RhomDev/projet_synth-se_broderie/docs/03_Capteurs_et_Synchronisation/Conditionnement_AOP_H21A1.md

---
titre: Module de Conditionnement du Signal Capteur (Comparateur LM393)
date: 2026-09-30
projet: Module Broderie
tags:
  - electronique
  - capteur
  - aop
  - comparateur
  - lm393
  - mks_base
  - kicad
  - pcb
statut: abandonne
aliases:
  - mise_en_service_capteur_h21a1
  - Conditionnement AOP H21A1
  - Module de correction du signal
  - Conditionnement LM393
---

# Module de Conditionnement du Signal Capteur (Comparateur LM393)

> [!WARNING] Module Obsolète / Remplacé (02/11/2026)
> Suite à l'abandon de la fourche optique H21A1, ce module de conditionnement analogique AOP/LM393 n'est plus requis dans l'architecture matérielle finale.
> Le microcontrôleur lit désormais directement un **[[Capteur_Fin_de_Course_Aiguille|fin de course mécanique standard]]** (contact sec 0V/5V) pour le homing et la position haute, et un **[[Encodeur_Rotatif_SEN0230|encodeur rotatif SEN0230]]**.
> Consulter la note explicative : `[[Note_Decision_Capteur_Fourche_H21A1|Note de Décision]]`.

## 1. Contexte et Problématique
La partie réceptrice du capteur optique à fente [[Fourche_Optique_H21A1|H21A1]]` se comporte comme une résistance variable. Selon la présence ou l'absence d'obstacle dans la fente, sa résistance interne passe de moins de $1\text{ M}\Omega$ à une valeur comprise entre $3\text{ M}\Omega$ et $6\text{ M}\Omega$.

<<<<<<< HEAD
* **À vide (mesure au multimètre) :** La tension varie parfaitement entre $5\text{ V}$ et environ $0{,}8\text{ V}$. Cette plage est théoriquement idéale pour le microcontrôleur de la carte `[[Carte_MKS_Base_V1_4|MKS Base V1.4]]`, car toute tension inférieure à $1{,}5\text{ V}$ est considérée comme un niveau logique bas (`LOW`) stable, permettant la détection fiable d'un front descendant (`FALLING`).
* **En charge (connecté à la carte hôte) :** Lorsque la sortie du capteur est reliée à l'entrée numérique du microcontrôleur, la tension basse remonte à cause des résistances internes de tirage de la carte. La tension stagne alors autour de $2{,}0\text{ V} - 2{,}5\text{ V}$, ce qui représente une zone d'incertitude instable pour l'étage d'entrée logique du processeur ATmega2560 ($1{,}5\text{ V} < V < 3{,}0\text{ V}$).
=======
* **À vide (mesure au multimètre) :** La tension varie parfaitement entre $5\text{ V}$ et environ $0{,}8\text{ V}$. Cette plage est théoriquement idéale pour le microcontrôleur de la carte [[Carte_MKS_Base_V1_4|MKS Base V1.4]]`, car toute tension inférieure à $1{,}5\text{ V}$ est considérée comme un niveau logique bas (`LOW`) stable, permettant la détection fiable d'un front descendant (`FALLING`).
* **En charge (connecté à la carte hôte) :** Lorsque la sortie du capteur est reliée à l'entrée numérique du microcontrôleur, la tension basse remonte à cause des résistances internes de tirage de la carte. La tension stagne alors autour de $2{,}0\text{ V} - 2{,}5\text{ V}$, ce qui représente une zone d'incertitude instable pour l'étage d'entrée logique du processeur ATmega2560.
>>>>>>> ce25f4e (Fix: résolution conflit workspace.json)

---

## 2. Choix Technologique : Du LM741/TL081 au Comparateur Dédié LM393
Pour isoler le capteur de l'influence de la carte et garantir une détection sans faille, nous avons conçu un module intermédiaire de conditionnement.

> [!IMPORTANT]
> Les tests expérimentaux avec des amplificateurs opérationnels classiques (LM741, TL081CN, LM318N) ont révélé qu'ils **ne conviennent pas** en alimentation unilatérale $0\text{ V} / 5\text{ V}$ car ils ne sont pas *rail-to-rail* (perte de $1{,}5\text{ V}$ à $2\text{ V}$ aux bornes).
> Le composant validé est le **LM393**, un vrai comparateur de tension à alimentation simple ($5\text{ V}$) avec sortie à collecteur ouvert (voir l'étude complète dans `[[comparateur-aop-choix]]` et la `[[Note_Decision_Capteur_Fourche_H21A1]]`).

Son rôle est de convertir la tension analogique instable issue du capteur en un signal tout-ou-rien digital parfaitement franc ($0\text{ V}$ ou $5\text{ V}$ purs) :

$$V_{out} = \begin{cases} 5\text{ V} & \text{si } V^+ > V^- \\ 0\text{ V} & \text{si } V^+ < V^- \end{cases}$$

```
                +5V
                 |
             [R_pullup]
                 |
      Capteur----+-----> (V+) Non-Inverseuse
      H21A1                |
                          |\
                          | \
                          |  \-----> Sortie Digitale D (vers MKS Pin 19)
                          |  /
    Potentiomètre -----> (V-) /
    (Seuil V_ref)         |/
```

---

## 3. Analyse du Montage Électrique
Le montage s'articule autour de trois blocs fonctionnels reliés à l'AOP (modélisé par un composant type LM741 / LM358) :

1. **Signal Capteur (Entrée Non-Inverseuse $V^+$) :** Le phototransistor forme un pont diviseur avec sa résistance de charge reliée au $5\text{ V}$. La tension à ce point est injectée sur la broche $V^+$.
2. **Seuil de Référence Ajustable (Entrée Inverseuse $V^-$) :** Un potentiomètre monté en pont diviseur entre $5\text{ V}$ et la masse permet d'ajuster manuellement la tension de seuil de référence $V_{\text{ref}}$ (fixée typiquement vers $1{,}5\text{ V} - 1{,}8\text{ V}$).
3. **Sortie Digitale Saturation :** L'AOP compare instantanément $V^+$ et $V^-$. Dès que le drapeau mécanique obture le faisceau, la tension chute sous $V_{\text{ref}}$, et la sortie bascule immédiatement à $0\text{ V}$ franc.

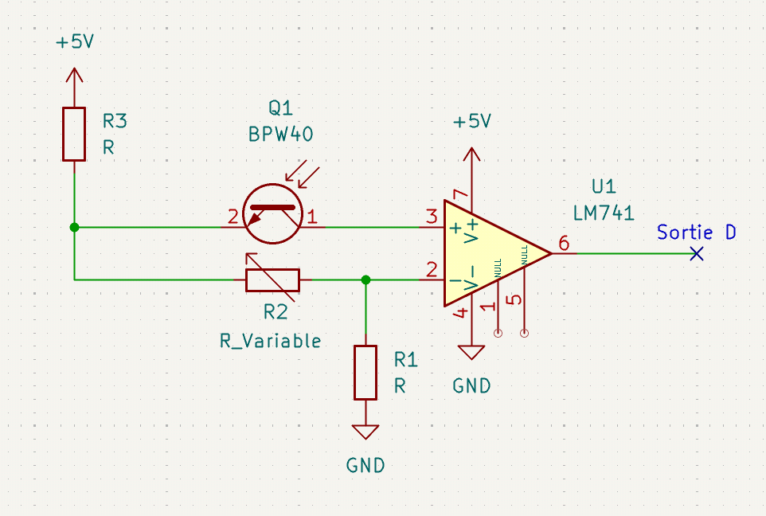
[picture p1: docs/assets/montage_correction.png]
Schéma de correction


---

## 4. Réalisation Matérielle (KiCad PCB)
Le circuit complet a été saisi et routé sous KiCad dans le dossier [`hardware/elect/carte_acquisition_capteur/`](file:///home/rhomdev/Documents/Ecole/projet_synth-se_broderie/hardware/elect/carte_acquisition_capteur/) :
* Schéma électronique : `carte_acquisition_capteur.kicad_sch`
* Circuit imprimé : `carte_acquisition_capteur.kicad_pcb`
* Trous de fixation : 3 trous mécaniques prévus pour fixation rigide sur le châssis.

---

## 5. Procédure de Calibration & Validation
1. Mettre le circuit sous tension $5\text{ V}$.
2. Relever au multimètre la tension haute ($V_{\text{haut}} \approx 4{,}8\text{ V}$) et basse ($V_{\text{bas}} \approx 2{,}2\text{ V}$) délivrées par le capteur sous charge.
3. Régler le potentiomètre pour que $V^-$ se situe exactement à la valeur médiane :
   $$V_{\text{ref}} = \frac{V_{\text{haut}} + V_{\text{bas}}}{2} \approx \frac{4{,}8 + 2{,}2}{2} = 3{,}5\text{ V}$$
4. Vérifier que la sortie bascule de façon nette entre $0\text{ V}$ et $5\text{ V}$ lors de la rotation de l'arbre.
5. Valider la réception d'interruption avec le sketch Arduino : `src/arduino/test_H21A1/test_H21A1.ino`.

---
**Voir aussi :**
<<<<<<< HEAD
* `[[Note_Decision_Capteur_Fourche_H21A1|Note de Décision : Maintien du H21A1 vs Encodeur]]`
* `[[comparateur-aop-choix|Note de Conception : Choix de l'AOP / Comparateur LM393]]`
* `[[Fourche_Optique_H21A1|Fiche Capteur H21A1]]`
* `[[Carte_MKS_Base_V1_4|Connexion à la Carte MKS Base]]`
* `[[00_Tableau_de_Bord|Tableau de Bord]]`
* Code de test : `src/arduino/test_H21A1/test_H21A1.ino`
=======
* [[Fourche_Optique_H21A1|Fiche Capteur H21A1]]`
* [[Carte_MKS_Base_V1_4|Connexion à la Carte MKS Base]]`
* [[00_Tableau_de_Bord|Tableau de Bord]]`
>>>>>>> ce25f4e (Fix: résolution conflit workspace.json)
