RhomDev/projet_synth-se_broderie/reports/presentation/Jalon_1.pptx

## Le projet et ses missions

CAHIER DES CHARGES

Objectif
Broder automatiquement un motif vectoriel avec une machine à coudre mécanique Janome Facility 21.

Point de départ
Un plateau XY à deux moteurs pas-à-pas et une carte MKS Base V1.4 (ATmega2560) sont déjà installés.

Mécanique
- Éviter les collisions avec la partie mobile du plateau
- Ajout d'un encodeur pour récupérer en temps réel la position verticale de l'aiguille

Icône Mécanique

Synchronisation
Ne déplacer le cadre que lorsque l'aiguille est sortie du tissu.

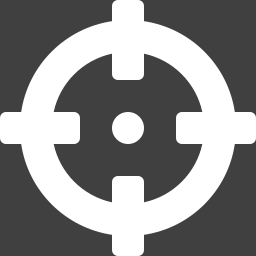
[picture p4: figure]
Icône Synchronisation

1 · Image

Moteur principal
Régler la vitesse du moteur 230 V avec un variateur à découpe de phase.

Icône Moteur principal

2 · Python : G-code

3 · MKS Base : firmware

Logiciel
Convertir un motif en G-code et l'envoyer à la carte par liaison série.

Icône Logiciel

4 · Machine : aiguille + plateau XY

Notes: Objectif : une machine à coudre mécanique qui brode toute seule un motif vectoriel. Le plateau XY et la carte MKS Base sont déjà installés. Quatre missions : mécanique, synchronisation avec l'aiguille, moteur principal, logiciel.

## Exigences et évolutions

CAHIER DES CHARGES

103,5 × 103,5 mm

Aire utile de broderie

DÉTECTION DE L'AIGUILLE
Prévu : Fourche optique H21A1 avec comparateur
Actuel : Fin de course mécanique + encodeur SEN0230
Pourquoi : électronique complexe, difficultés à détecter l'obstacle (peu d'influence sur la tension en sortie du capteur).

≈ 860 tr/min

Vitesse maximale de la machine

15 à 30 ms

Fenêtre pour déplacer le cadre à chaque tour

Avant le 18/12

Première broderie complète

À définir

Vitesse de couture et précision

VARIATEUR DU MOTEUR
Prévu : Module variateur RobotDyn
Actuel : RobotDyn pour tester ; variateur fait maison en bonus
Pourquoi : un variateur sûr pour tester, et de l'expérience en conception.

Règle absolue : le cadre ne bouge jamais tant que l'aiguille est dans le tissu.

Notes: À gauche, les exigences fixées dans le cahier des charges (la vitesse de couture et la précision ne sont pas encore définies). À droite, les deux évolutions depuis la première version : le capteur d'aiguille (décision du 2 novembre) et le variateur.

## Planning : ce qui est fait

PLANNING · CE QUI EST FAIT

28/09

05/10

12/10

19/10

26/10

02/11

Phase 1 : Cadrage & Spécifications

Prise en main du sujet & définition du besoin

Analyse de la machine Janome Facility 21

Rédaction du Cahier des Charges fonctionnel

Déploiement coffre Obsidian & arborescence Git

Phase 2 : Études Préliminaires & Choix Techniques

Analyse de la carte MKS Base V1.4 (ATmega2560)

Étude du variateur AC RobotDyn (découpe de phase)

Étude théorique Fast PWM vs découpe AC

Étude initiale de la fourche optique H21A1

Conception PCB comparateur AOP pour H21A1

Essais comparateurs (LM318, TL081, LM393)

Phase 3 : Expérimentation, Tests Manuels & Pivot

Dimensionnement cinématique poulie encodeur

Test manuel couture machine (carré piqué réussi)

Décision : Abandon H21A1 au profit du Fin de Course

Choix du fin de course à galet (PMH & homing)

Validation encodeur rotatif SEN0230 (< 5000 tr/min)

Établissement de la liste des besoins (BOM)

Notes: Les trois premières phases du Gantt sont terminées : cadrage, études préliminaires, puis tests manuels et pivot sur les capteurs.

## Planning : ce qu'il reste à faire

PLANNING · CE QU'IL RESTE À FAIRE

02/11

16/11

30/11

14/12

28/12

11/01

25/01

4 · Conception mécanique & achats 04/11 → 19/11
Commande, plateau XY, poulie, support encodeur, came

5 · Électronique & câblage 11/11 → 20/11
Boîtier 230 V, câblage moteurs, capteurs, encodeur

6 · Firmware Arduino 16/11 → 04/12
Variateur, encodeur, homing, synchro aiguille/XY, G-code

7 · Logiciel Python 20/11 → 11/12
Liaison série, extraction SVG, G-code, visualiseur 2D

8 · Intégration & essais 04/12 → 18/12
Essais à vide, premier carré, optimisation, motif complet

Vacances de Noël 19/12 → 01/01

9 · Rapport & soutenance 04/01 → 28/01
Rapport, diaporama et vidéo, répétitions, soutenance

Aujourd'hui (03/11)

◆ Soutenance 28/01

Notes: Les six phases restantes, de novembre à la soutenance du 28 janvier. Les tâches détaillées de chaque phase sont dans le Gantt du dépôt.

## Matériel à acheter

MATÉRIEL

Désignation | Qté | Prix | Rôle
Encodeur rotatif SEN0230 | 1 | 29,90 € | Suivi de vitesse et d'angle
Variateur AC RobotDyn | 1 | 29,04 € | Variateur de référence (230 V) (Bonus -> variateur maison)
Fins de course du plateau X/Y | 4 | 11,20 € | Homing et butées de sécurité
Fin de course de l'aiguille | 1 | 2,80 € | Point mort haut et homing (type à confirmer)
Variateur fait maison : H11AA1, MOC3021M, BTA16-600C | 3 | 4,04 € | Variateur fait maison (Bonus -> Variateur AC RobotDyn)
Total | | 76,98 € | dont 4,04 € ou 29,04 € de bonus

Poulie crantée de l'encodeur : impression 3D, sans achat.

Notes: Budget total d'environ 77 euros. Un des deux variateurs est un bonus : les trois composants du variateur fait maison (4,04 euros) si on utilise le RobotDyn, ou le RobotDyn (29,04 euros) si on utilise le variateur fait maison. La poulie de l'encodeur est imprimée en 3D.
