RhomDev/projet_synth-se_broderie/docs/01_Gestion_Projet/Tutoriel_Machine_a_Coudre.md

---
titre: Tutoriel Prise en Main & Enfilage — Machine à Coudre Janome Facility 21
date: 2026-11-02
projet: Module Broderie
tags:
  - machine
  - couture
  - tutoriel
  - video
statut: valide
aliases:
  - Tuto Machine a Coudre
  - Video Janome
---

# 🧵 Tutoriel Vidéo : Fonctionnement & Enfilage de la Janome Facility 21

Ce tutoriel vidéo a servi de support d'apprentissage pour la prise en main de la machine, le bobinage de la canette, le passage du fil supérieur et le réglage des tensions lors de la séance du 02 novembre 2026 :

* **Lien vidéo YouTube :** [Tutoriel Machine à Coudre Janome Facility 21](https://www.youtube.com/watch?v=w-LbGgq0WxE)

---
**Voir aussi :**
*  [[2026-11-02|Journal du 02 Novembre 2026 (Essais réussis)]] 
*  [[fiche technique - janome facility 21.pdf|Fiche Technique Janome Facility 21]]
