RhomDev/projet_synth-se_broderie/docs/templates/Template_Fiche_Technique.md

---
titre: 
date: {{date}}
projet: Module Broderie
tags:
  - fiche_technique
  - electronique
  - materiel
statut: en cours
aliases:
  - 
---

# {{title}}

## 1. Présentation & Rôle dans le Projet
<!-- Décrire ici la fonction du composant/module et pourquoi il est utilisé dans la brodeuse -->

## 2. Caractéristiques Techniques Principales
<!-- Tableau ou liste à puces des spécifications clés (tension, courant, fréquence, etc.) -->

| Paramètre | Valeur | Remarques |
| :--- | :--- | :--- |
| **Tension d'alimentation** | | |
| **Interface de commande** | | |
| **Composant clé** | | |

## 3. Schéma de Câblage & Intégration
<!-- Schéma de raccordement avec la carte MKS Base ou les capteurs -->

## 4. Code / Firmware Associé
<!-- Extrait de code de test ou de configuration des registres -->

```cpp
// Code d'exemple / configuration
```

## 5. Tests, Mesures & Validation
<!-- Relevés expérimentaux, captures de signaux, points de vigilance -->

---
**Références & Documents associés :**
* `[[00_Tableau_de_Bord|Tableau de Bord]]`
*
