RhomDev/projet_synth-se_broderie/docs/templates/Template_Tache.md

---
titre: 
date: {{date}}
projet: Module Broderie
tags:
  - tache
  - gestion_projet
statut: a_faire
priorite: moyenne
responsable: 
---

# 📌 {{title}}

## 1. Description du Besoin / Objectif
<!-- Pourquoi cette tâche est nécessaire et quel est le résultat attendu -->

## 2. Critères d'Acceptation & Validation
- [ ] 
- [ ] 

## 3. Notes Techniques & Démarche
<!-- Schémas, liens vers la documentation, démarches de test -->

## 4. Résultats & Clôture
<!-- Relevés, photos ou liens vers les commits réalisant la tâche -->

---
**Voir aussi :**
* `[[Suivi_des_Taches|Feuille de Route Générale]]`
* `[[00_Tableau_de_Bord|Tableau de Bord]]`
