RhomDev/projet_synth-se_broderie/docs/assets/IMG_20260925_122632_784.jpg

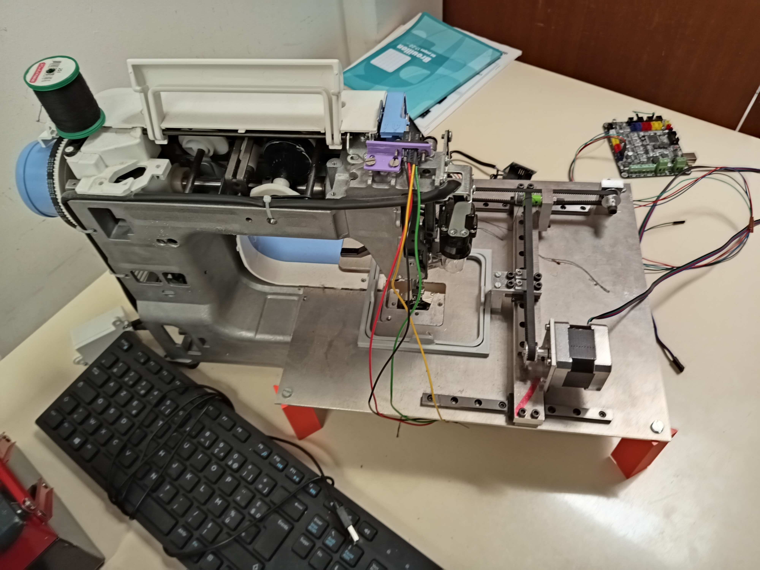
docs/assets/IMG_20260925_122632_784.jpg
