RhomDev/projet_synth-se_broderie/docs/assets/IMG_20260925_122636_920.jpg

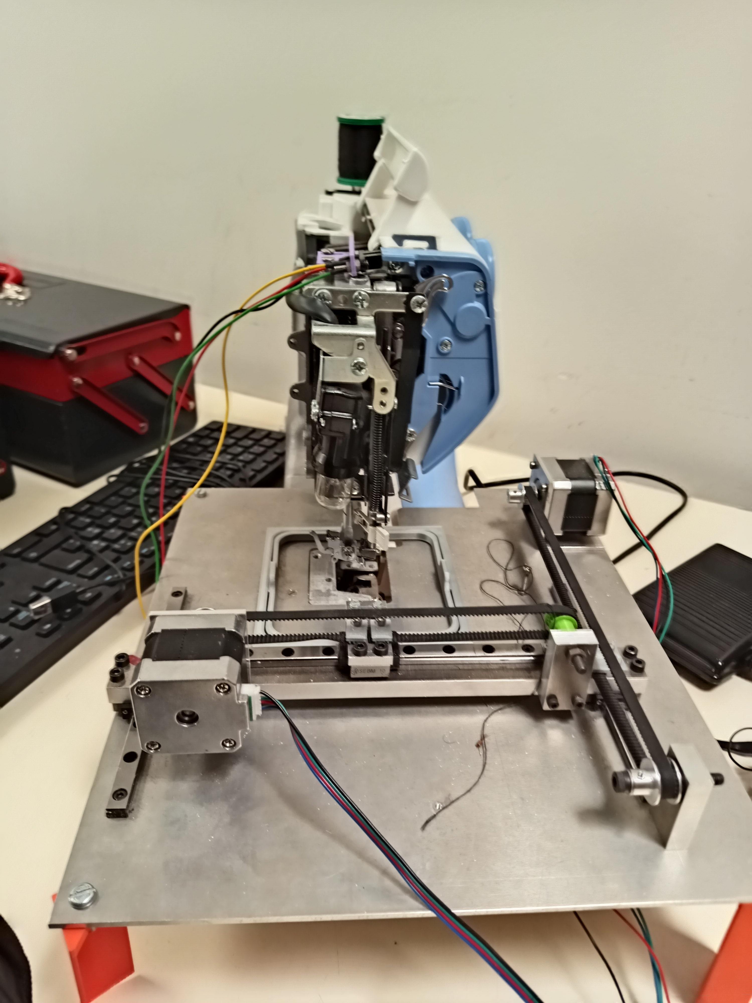
docs/assets/IMG_20260925_122636_920.jpg
