RhomDev/projet_synth-se_broderie/docs/assets/IMG_20260925_122641_185.jpg

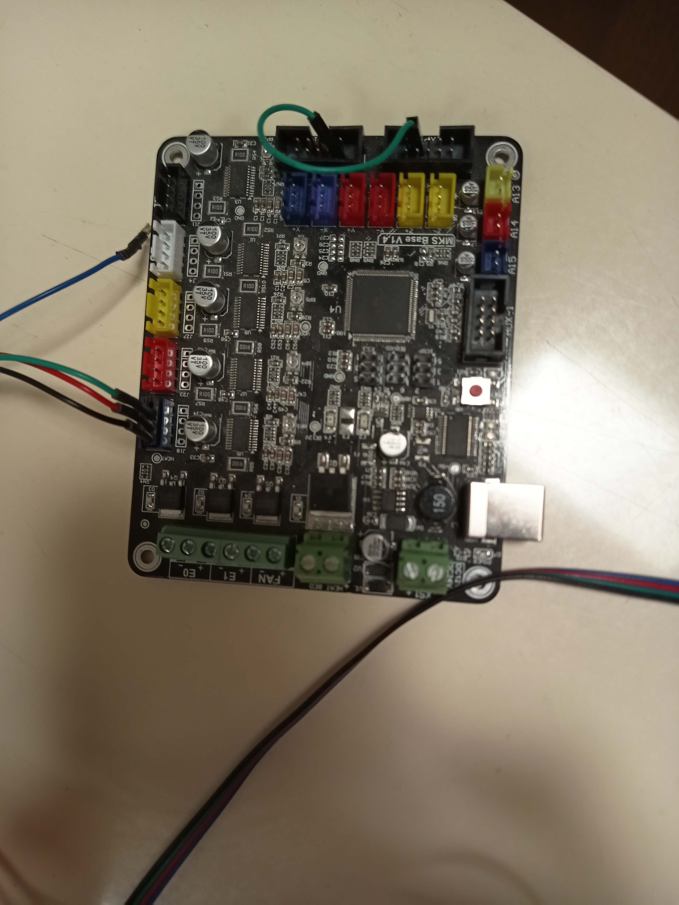
docs/assets/IMG_20260925_122641_185.jpg
