RhomDev/projet_synth-se_broderie/docs/assets/IMG_20260925_122648_890.jpg

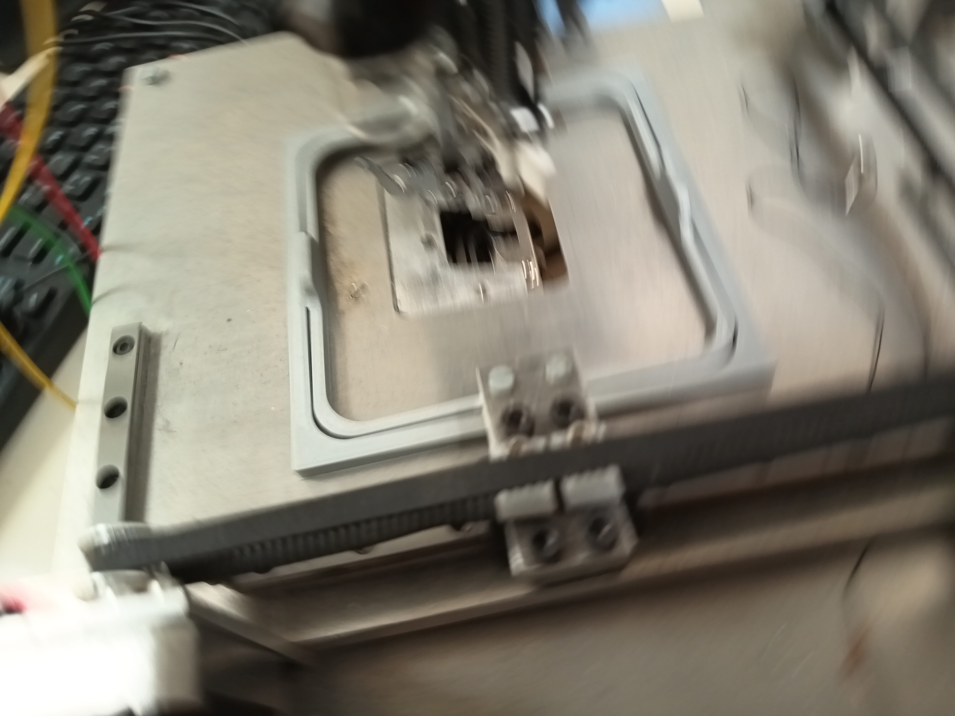
docs/assets/IMG_20260925_122648_890.jpg
