RhomDev/projet_synth-se_broderie/docs/assets/IMG_20260925_122655_627.jpg

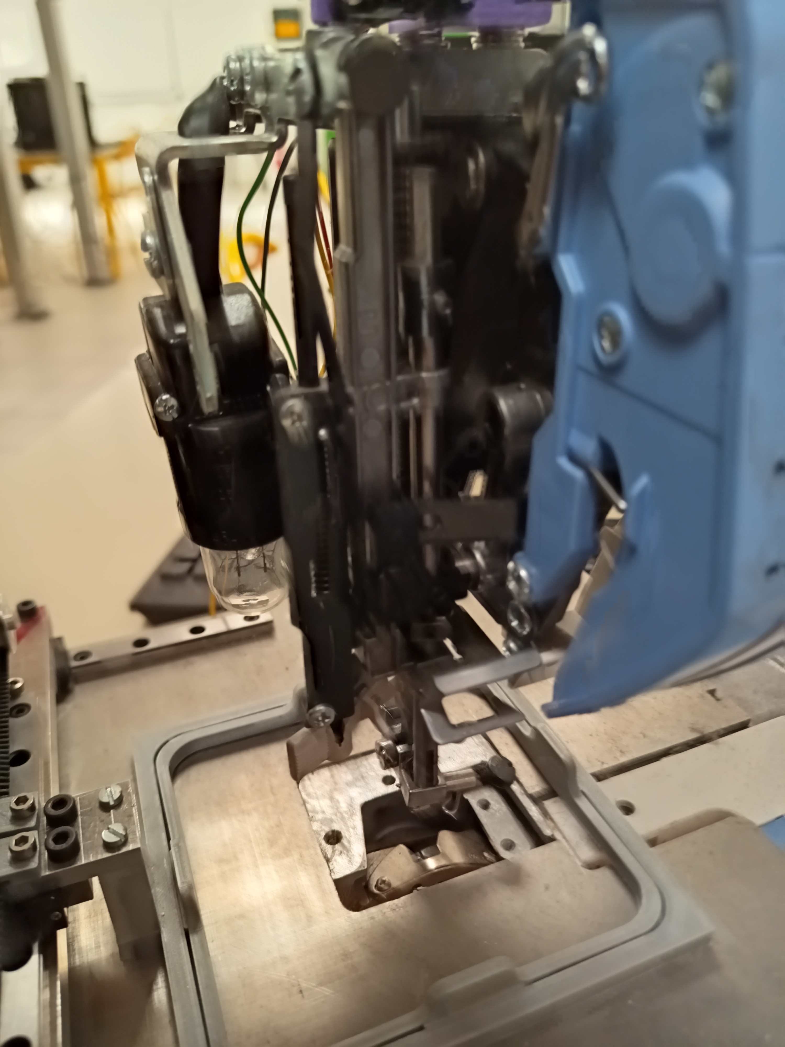
docs/assets/IMG_20260925_122655_627.jpg
