RhomDev/projet_synth-se_broderie/docs/assets/IMG_20260925_122702_841.jpg

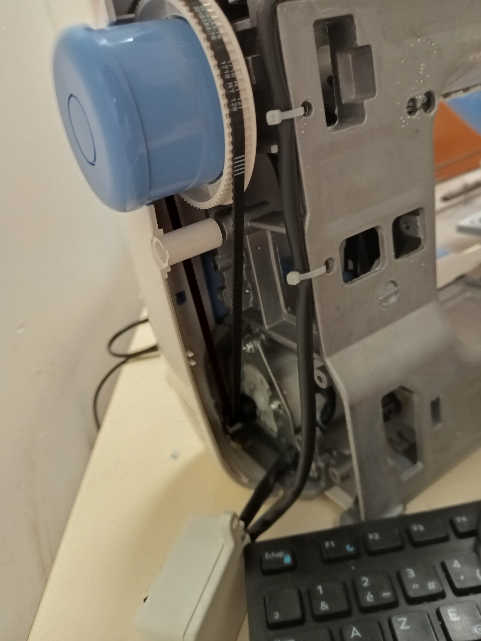
docs/assets/IMG_20260925_122702_841.jpg
