RhomDev/projet_synth-se_broderie/hardware/elect/Variation_AC.png

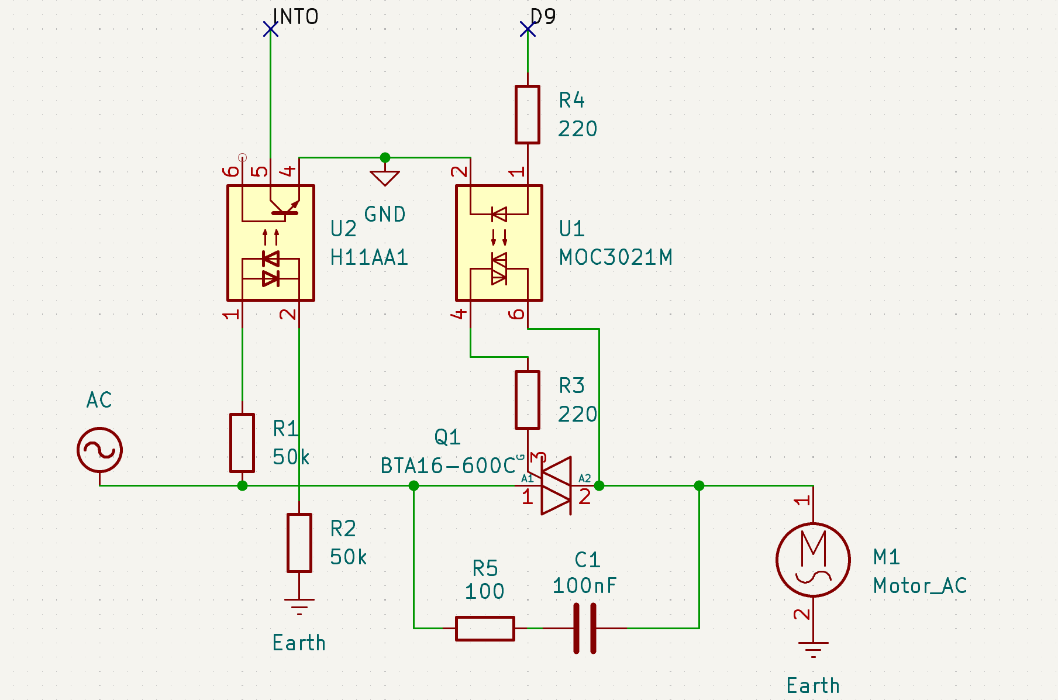
hardware/elect/Variation_AC.png
