RhomDev/projet_synth-se_broderie/docs/02_Electronique_et_Puissance/Produits_a_acheter.xlsx

 |  | reference | quantity | prix | total | liens
 |  |  |  |  | 0
 |  |  |  |  | 0
hacheur RobotDyn | hacheur complet | sku EB0046830 | 1 | 29.04 | 29.04 | Module variateur de lumière AC pour contrôleur PWM, 1 canal 3.3V/5V logique AC 50hz 60hz 220V 110V pour Arduino (https://www.elecbee.com/fr/product-detail/ac-light-dimmer-module-for-pwm-controller-1-channel-3-3v-5v-logic-ac-50hz-60hz-220v-110v-for-arduino_28960)
Détection du passage à zéro du secteur |  | H11AA1 (U2) | 1 | 1.4 | 1.4 | https://www.gotronic.fr/art-optocoupleur-h11aa1-31848.htm
opto-triac | Opto-triac sans détection de zéro | MOC3021M (U1) | 1 | 1.04 | 1.04 | Optotriac MOC3021 | Gotronic (https://www.gotronic.fr/art-optotriac-moc3021-2360.htm)
Triac |  | BTA16-600C (Q1) | 1 | 1.6 | 1.6 | https://www.gotronic.fr/art-triac-bta16-600c-22671.htm
 |  |  |  |  | 0
Récepteur IR |  | TSOP2238 | 1 | 0.89 | 0.89 | TSOP2238 | Récepteur IR Vishay, 38 kHz ±45° 5.5V 45 m 2.5 V Traversant TSOP 6.95 mm 3 broches 6 mm 5.6mm | RS (https://fr.rs-online.com/web/p/recepteurs-ir/7085562?gb=a)
Led IR |  | SIR-56ST3F | 1 | 0.51 | 0.51 | SIR-56ST3F | Diode infrarouge, ROHM 2 broches, Traversant, 8 mW/sr, 950 nm DIP | RS (https://fr.rs-online.com/web/p/leds-infrarouges/1780575?gb=a)
 |  |  |  |  | 0
 |  |  |  |  | 0
butee fin de course | pour les deplacement du plateau |  | 4 | 2.8 | 11.2
 |  |  |  | total | 45.68
