RhomDev/projet_synth-se_broderie/(list of files, cad)

Other CAD files:
hardware/meca/support2_led_capteur.prt
hardware/meca/support_led_capteur_V2.prt
hardware/meca/tige.prt
hardware/meca/tuillère_broderie.prt
hardware/meca/tuillère_broderie_axe_x.prt
