RhomDev/projet_synth-se_broderie/reports/journal/2026-11-05.md

---
titre: Journal de bord - 2026-11-05
date: 2026-11-05
tags:
  - journal
  - projet_broderie
  - decision
  - capteurs
  - impression_3d
  - mecanique
  - electronique
  - firmware
statut: valide
aliases:
  - Journal du 05 Novembre 2026
---

# Journal de bord — 05 novembre 2026

## 👥 Intervenants
* **RhomDev** (Romaric Pradeau)
* **matazzo** (Maé Tazzioli)

---

## 1. Travaux Réalisés

### Pôle Réflexion & Décisions (après la soutenance intermédiaire)
* **Abandon de l'encodeur SEN0230.** Après réflexion et sur les conseils reçus après la soutenance intermédiaire, l'encodeur n'est plus retenu. Cette décision remplace l'architecture hybride validée le 2 novembre (fin de course + encodeur).
* **Étude de la plage de temps pour déplacer le tissu.** Le cadre ne peut bouger que lorsque l'aiguille est sortie du tissu et que la tension du fil est bonne. Cette plage est la fenêtre d'avance (détail dans la section « Étude du moment exact du déplacement du tissu »).
* **Principe retenu : deux capteurs optiques sur la course de l'aiguille.**
  * Une tige fixée au bout de l'aiguille monte et descend avec elle, et passe dans la fourche de chaque capteur : elle coupe le faisceau entre l'émetteur et le récepteur.
  * Le **capteur bas** détecte l'aiguille au niveau où le mouvement du tissu doit commencer. Le mouvement démarre quand l'aiguille, en remontant, déclenche ce capteur.
  * Le **capteur haut** détecte l'aiguille tout en haut. Le mouvement doit être terminé quand l'aiguille y arrive.

### Étude du moment exact du déplacement du tissu
Les valeurs d'angle ci-dessous sont des ordres de grandeur : elles dépendent du modèle de machine et doivent être mesurées sur la Facility 21.

**Sur une machine à coudre classique**, le tissu avance quand l'aiguille est sortie du tissu, pendant la remontée. Un cycle de point se déroule ainsi :
1. **Aiguille en bas** (pointe sous la plaque à aiguille) : le pied-de-biche maintient le tissu, les griffes sont abaissées sous la plaque. Le crochet attrape la boucle du fil supérieur.
2. **Aiguille qui remonte** : dès que la pointe est sortie du tissu, les griffes d'entraînement se soulèvent à travers la plaque, serrent le tissu contre le pied-de-biche et le tirent vers l'arrière, d'une longueur égale à celle du point.
3. **Aiguille en haut** : les griffes redescendent sous la plaque, le tissu est libre.
4. **Aiguille qui redescend** : le tissu doit être immobile avant que la pointe ne le perce de nouveau.

Si le tissu bouge aiguille engagée, l'aiguille se tord ou casse et le point est faussé. Mécaniquement, le calage entre l'arbre principal (aiguille et crochet) et l'arbre d'entraînement, par came excentrique ou bielle, garantit ce déphasage. Les griffes décrivent une trajectoire quasi elliptique (montée, avance, descente, retour). L'avance s'effectue pendant environ **120 à 180° de rotation de l'arbre principal**, centrés autour de la phase où l'aiguille est haute.

**Condition nécessaire mais pas suffisante : la tension du fil.** « Aiguille sortie du tissu » ne suffit pas : si le fil est encore engagé dans le tissu et que le crochet tient la boucle, avancer trop tôt tire le fil de travers, déforme le point ou casse le fil. Séquence indicative sur un point (0° = aiguille en haut) :

| Phase | Angle indicatif | Ce qui se passe |
| :--- | :--- | :--- |
| Descente | ~0° à ~100° | L'aiguille perce le tissu vers 70 à 90° : le tissu doit être immobile avant. |
| Aiguille en bas, boucle | ~180° à ~200° | Le fil forme une boucle quand l'aiguille remonte légèrement, et le crochet l'attrape. |
| Remontée | ~200° à ~300° | Le crochet emporte la boucle autour de la canette. L'aiguille sort du tissu vers 270 à 300°. |
| Serrage du point | ~300° à ~360° | Le tire-fil (levier de tension) monte et resserre le point. |

**Fenêtre utile :** de la fin du serrage du point (tire-fil à peu près en haut) jusqu'à l'entrée de la pointe dans le tissu à la descente, soit à peu près **300° → 360° → 60°**. C'est cohérent avec les machines classiques (entraînement sur environ 120° centrés sur l'aiguille haute).

**Pour mesurer la plage exacte sur la Facility 21 :**
1. Tourner le volant à la main, avec un tissu fin et un fil visible.
2. Relever l'angle de la sortie de la pointe du tissu, du début et de la fin de la montée des griffes, de la position haute du tire-fil, et de l'entrée de la pointe à la descente.
3. Avancer le tissu sur des fenêtres de plus en plus larges et observer à partir de quand le fil tire ou que le point se dégrade. Garder une marge de sécurité de 10 à 15° de chaque côté.

**Pour la broderie**, il n'y a pas de griffes : l'axe XY joue ce rôle. La fenêtre se règle donc dans le code et peut être plus stricte que celle d'une machine classique, pour protéger le fil. La règle des deux capteurs (mouvement lancé quand l'aiguille remontante déclenche le capteur bas, terminé quand elle arrive en haut) s'inscrit dans cette fenêtre, et s'arrête avant l'entrée de la pointe dans le tissu.

### Pôle Capteurs
* **Alternatives à la fourche H21A1 étudiées :** modules à fourche optique avec comparateur LM393 (FC-03, HW-206), qui donnent une vraie sortie tout ou rien directement exploitable par un Arduino, et capteurs à effet Hall (A3144, KY-003) avec un aimant, insensibles à la poussière et aux peluches. Le H21A1 seul n'a pas de trigger de Schmitt : ses fronts sont mous et peuvent causer des rebonds ou de faux comptages.
* **Capteur optique plus performant trouvé :** fourche optique **Vishay TCST2300** (fente de 0,25 mm, résolution spatiale de 0,2 mm). La fiche `[[Capteur_Optique_TCST2300]]` et sa datasheet sont ajoutées au dépôt, et les datasheets de la LED IR et du récepteur TSOP22 sont rangées dans `docs/datasheets/detection_aiguille/`.
* **Capteur de fin de course pour le plateau trouvé** (axes X et Y).

### Pôle Fabrication (impression 3D)
* **Support des capteurs de l'aiguille.**
* **Tige** placée au bout de l'aiguille : elle passe dans la fourche des capteurs optiques et bloque la lumière entre l'émetteur et le récepteur quand l'aiguille monte ou descend.
* **Supports des fins de course du plateau :** ils maintiennent les capteurs et se clipsent ou glissent dans les rails X et Y où coulisse le support qui porte le plateau.
* Les fichiers CAO correspondants (`hardware/meca/support_led_capteur_V2.prt`, `support2_led_capteur.prt`, `tige.prt`) sont ajoutés au dépôt le 9 novembre.

### Pôle Électronique
* **Soudage des fils** sur les capteurs de fin de course.

### Pôle Firmware
* **Initialisation des registres** pour contrôler les moteurs pas à pas : broches STEP, DIR et ENABLE, broches MS1 et MS2 des drivers A4982 (micropas 1/16) et timer de génération des impulsions (`src/arduino/controle_moteur_step/main_controle_motor.ino`).
* Programme de détection de l'aiguille mis à jour (`src/arduino/detection_aiguille/detection_aiguille.ino`).

---

## 2. Arbitrages & Points de Vigilance

| Sujet | Conséquence | À faire |
| :--- | :--- | :--- |
| **Abandon de l'encodeur** | La fenêtre d'avance ne vient plus d'un angle mesuré, mais du temps entre les deux capteurs. La vitesse de couture ne se mesure plus par l'encodeur. | Mettre à jour les fiches qui parlent encore de l'encodeur (`[[Encodeur_Rotatif_SEN0230]]`, `[[Cahier_des_Charges]]`, `[[Architecture_Logicielle]]`, `[[BOM_Liste_des_Besoins]]`). |
| **Tige dans la fourche** | La tige doit passer dans la fente à chaque cycle, sans frotter ni sortir de l'alignement. | Valider l'alignement et le jeu sur la machine. |
| **Position du capteur bas** | Elle fixe le début de la fenêtre d'avance. | La régler en observant à quel moment l'aiguille quitte le tissu. |

---

## 3. Prochaines Étapes
D'après la feuille de route `[[Suivi_des_Taches]]` :
- [ ] Câbler les fins de course (aiguille, X, Y) sur la carte `[[Carte_MKS_Base_V1_4]]` (tâche 5.4).
- [ ] Monter les supports imprimés sur la machine et tester le passage de la tige dans les fourches.
- [ ] Homing de l'aiguille et des axes X et Y (tâches 6.2 et 6.3).
- [ ] Machine à états de synchronisation de l'aiguille avec les deux capteurs (tâche 6.4).

---

## ⏱ Historique des Commits de la Journée
* **11:38:38** (`99493f1` - *RhomDev*) : `rangement datasheet`
* **15:51:46** (`7681820` - *matazzo*) : `Delete docs/02_Electronique_et_Puissance/Produits_a_acheter.xlsx`
* **15:52:02** (`641ca86` - *matazzo*) : `Add files via upload` (`Produits_a_acheter.xlsx`)
* **16:57:45** (`505d620` - *RhomDev*) : `detection aiguille` (ajout de `Capteur_Optique_TCST2300.md` et de la datasheet TCST2300)
* **17:36:24** (`5a5b31c` - *RhomDev*) : `program arduino mj`
