RhomDev/projet_synth-se_broderie/reports/journal/2026-11-12.md

---
titre: Journal de bord - 2026-11-12
date: 2026-11-12
tags:
  - journal
  - projet_broderie
  - moteurs_pas_a_pas
  - cinematique
  - modele
  - python
  - architecture
  - decision
statut: en cours
aliases:
  - Journal du 12 Novembre 2026
---

# Journal de bord — 12 novembre 2026

Journal arrêté à 16 h 45, à partir des échanges du jour et des commits déjà poussés.

## 👥 Intervenants
* **RhomDev** (Romaric Pradeau)
* **matazzo** (Maé Tazzioli)

---

## 1. Travaux Réalisés

### Pôle Moteur & Cinématique : accélération et vitesse maximales du 17HS4401
* **Doc du moteur ajoutée au dépôt** (`docs/datasheets/moteur_step/17HS4401.pdf`). Le datasheet ne contient que le tableau électrique, sans courbe couple-vitesse : il faut passer par un modèle. Valeurs utilisées : 40 N·cm, 1,7 A, 1,5 Ω, 2,8 mH, rotor 54 g·cm².
* **Formule de l'accélération maximale démontrée** à partir des lois de la mécanique (moment dynamique, P.F.D., énergie cinétique, puissance). La masse est ramenée à l'arbre par $J_{eq} = m\,r^2$. Les frottements sont négligés en fin de calcul (environ 1 % du couple) :

  $$a_{max} = \frac{C_{dispo}}{\dfrac{J_{rotor}}{r} + m\,r}$$

* **Couple utilisable :** $C_{dispo} = 0{,}20$ N·m, soit la moitié du couple de maintien, pour éviter le décrochage.
* **Vitesse maximale :** vitesse du coude de la courbe couple-vitesse, $V/(2\,L\,I\,spr)$ avec $spr = 200$ (pas entiers, pas les micropas). Avec la poulie GT2 de 20 dents ($r = 6{,}37$ mm) : **252 mm/s à 12 V**, 504 mm/s à 24 V.
* **Profil de vitesse :** trapèze, qui devient un triangle pour les petits pas. On planifie à partir de la durée de la fenêtre. Une courbe en S ne serait utile que si des vibrations apparaissent à l'arrêt.
* **Résultats** (12 V, fenêtre de 40 ms) :

  | Masse déplacée | $a_{max}$ | $x_{max}$ en 40 ms |
  | :--- | :--- | :--- |
  | 0 g (rotor seul) | 236 m/s² | 9,8 mm |
  | 1 kg | 27,7 m/s² | 7,8 mm |
  | 3 kg | 10,0 m/s² | 4,0 mm |

* **Document de démonstration :** `[[Acceleration_Max_Moteur_17HS4401]]` (version Word et version `.md`).

### Pôle Tableur de calcul
* **`calcul_stepper_moteur.xlsx`** ajouté au dépôt (`docs/02_Electronique_et_Puissance/`) avec les valeurs choisies : 12 V, vitesse du coude, $a_{max}$ de 100 m/s², fenêtre de 40 ms. Trois corrections identifiées :
  * **Formule de `x_max`** : le terme d'accélération et de décélération vaut $a\,t_1^2$ et non $2\,a\,t_1^2$ (15,84 mm devient 14,27 mm avec les valeurs du tableur).
  * **Rayon `E10`** : la poulie est bien un **GT2 de 20 dents**, soit 6,37 mm et non 10 mm. La vitesse maximale passe de 396 à 252 mm/s.
  * **`a_max` saisi à la main** : à calculer à partir de la masse. 100 m/s² n'est tenable que pour une masse d'environ 0,18 kg ou moins.

### Pôle Logiciel Python
* **`src/python/algorithms/motion_model.py`** (268 lignes), qui remplace le tableur. Il calcule $a_{max}$, la vitesse du coude, le profil trapèze ou triangle (`plan_fastest`, `plan_in_window`), la distance maximale dans la fenêtre (`max_distance`) et les conversions en micropas. Valeurs par défaut : GT2 20 dents, masse 0 g, frottements nuls, marge de sécurité 0,5, micropas 1/16.
* **Tests `pytest`** (`src/python/tests/test_motion_model.py`) : 21 tests qui reprennent les valeurs de référence. Ils ne sont pas encore poussés sur le dépôt.

### Pôle Architecture : aiguille, plateau, microcontrôleur, Python
* **Encodeur abandonné, deux capteurs** (décision du 5 novembre, `[[2026-11-05|journal du 5 novembre]]`). Le mouvement du tissu démarre quand l'aiguille, en remontant, déclenche le capteur bas, et doit s'arrêter quand elle arrive tout en haut (capteur haut). Le microcontrôleur peut donc **mesurer la fenêtre** entre les deux capteurs, et la durée entre deux passages au point haut donne la vitesse de couture.
* **Répartition retenue entre le microcontrôleur et Python :**
  * Python, hors temps réel : conversion du motif en points puis en G-code de broderie, envoi par le pont série (`serial_bridge.py`), vérification que le motif est faisable (module `stitch_check.py`, à écrire).
  * Microcontrôleur, temps réel : décodage du G-code et file de pas, déclenchement du pas suivant par le capteur bas, impulsions STEP/DIR avec rampe d'accélération, homing, pilotage du variateur.
* **Étude du moment d'avance du tissu** (conversation du matin) : le tissu avance quand l'aiguille est hors du tissu, pendant la montée. Les griffes d'entraînement se lèvent, saisissent le tissu, le tirent, puis redescendent avant que l'aiguille rentre à nouveau. Cela représente environ 120 à 180° de rotation de l'arbre principal. Les valeurs exactes sont à vérifier à la main sur la Facility 21. La même conversation a comparé des alternatives à la fourche H21A1 : modules à fourche LM393 (FC-03, HW-206) et capteurs à effet Hall (A3144, KY-003).

### Pôle Infrastructure & Dépôt
* **Sketch de test** des axes X et Y (`src/arduino/sketch_controle_moteur_step/`) : commande par la console série (par exemple `X200`, `Y-50`), avec des impulsions bloquantes (`delayMicroseconds`). Il sert aux essais, pas à la production.
* **Pièce mécanique** `hardware/meca/tuillère_broderie_axe_x.prt` ajoutée.
* Nettoyage : suppression d'un fichier Python vide (`communication_broderie.py`) et fusions des branches de RhomDev et de matazzo (`.gitignore`, datasheets, `test_H21A1.ino`).

---

## 2. Difficultés Rencontrées & Arbitrages

| Problème Rencontré | Impact sur le Projet | Décision & Solution |
| :--- | :--- | :--- |
| **Formule de `x_max` erronée dans le tableur** | La distance maximale était surestimée de 1,6 mm. | Formule corrigée dans la fiche et dans le module Python. Le tableur reste à mettre à jour. |
| **Rayon de poulie de 10 mm dans le tableur** | Vitesse maximale surestimée (396 au lieu de 252 mm/s). | Poulie GT2 de 20 dents confirmée : 6,37 mm. |
| **Accélération saisie à 100 m/s²** | Elle ne dépend pas de la charge et n'est tenable que pour une masse très faible. | Calcul de $a_{max}$ à partir de la masse (module Python). Masse encore à mesurer. |
| **`_acceleration` en `uint16_t` dans le firmware** | Maximum 65 535 pas/s², soit environ 0,8 m/s² si l'unité est le micropas de 12,5 µm : bien en dessous des 10 à 20 m/s² nécessaires. | À passer en `uint32_t`. La logique de rampe reste à relire. |
| **Cadence d'impulsions à 24 V** | 40 000 micropas/s sur un axe, lourd pour l'ATmega2560 avec deux axes. | Rester à 12 V, ou passer à 1/8 de micropas. À décider. |
| **Fichier de verrou Excel poussé par erreur** (`~$calcul_stepper_moteur.xlsx`) | Fichier inutile dans le dépôt. | À supprimer et à ajouter au `.gitignore`. |
| **Fiches encore basées sur l'encodeur** | Incohérence avec la décision du 5 novembre. | À mettre à jour (voir ci-dessous). |

---

## 3. Prochaines Étapes
- [ ] Mesurer la masse déplacée sur X et sur Y (cadre, chariot, tissu).
- [ ] Mesurer le courant réglé sur les A4982 (Vref).
- [ ] Mesurer sur la machine la fenêtre entre les deux capteurs à plusieurs vitesses de couture.
- [ ] Écrire `stitch_check.py` : vérifier chaque pas d'un motif dans la fenêtre mesurée et en déduire la vitesse de couture maximale.
- [ ] Décider avec l'équipe : qui déclenche le mouvement (firmware par capteur, ou tampon envoyé par Python), comment régler la vitesse de couture, ce qui se passe si un pas n'est pas fini au capteur haut.
- [ ] Passer `_acceleration` en `uint32_t` et relire la rampe d'accélération.
- [ ] Choisir entre 12 V et 24 V.
- [ ] Corriger le tableur (`E10`, `E13`, `E15`).
- [ ] Pousser les tests et supprimer le fichier de verrou Excel.
- [ ] Mettre à jour les fiches qui mentionnent l'encodeur : `[[Encodeur_Rotatif_SEN0230]]`, `[[Cahier_des_Charges]]`, `[[Architecture_Logicielle]]`, `[[Suivi_des_Taches]]`, `[[BOM_Liste_des_Besoins]]`.

---

## ⏱ Historique des Commits de la Journée
* **11:20:33** (`ca660ef` - *matazzo*) : `push _doc_stepper_motor` (`17HS4401.pdf`, `tuillère_broderie_axe_x.prt`)
* **11:23:45** (`4d6f60d` - *RhomDev*) : `merge rhom` (`.gitignore`, `sketch_controle_moteur_step.ino`, `test_H21A1.ino`, datasheets)
* **15:13:21** (`1f50e7c` - *matazzo*) : `maj` (`calcul_stepper_moteur.xlsx`)
* **15:42:34** (`dcaa450` - *matazzo*) : `add python file` (`motion_model.py`)
* **15:43:42** (`27e5262` - *matazzo*) : `suppression fichier inutile`
* **15:44:11** (`5bca0dd` - *matazzo*) : `Merge branch 'main' of https://github.com/RhomDev/projet_synth-se_broderie`
