RhomDev/projet_synth-se_broderie/reports/journal/2026-10-23.md

---
titre: Journal de bord - 23 octobre 2026
date: 2026-10-23
tags:
  - journal
  - projet_broderie
  - capteurs
  - electronique
  - mecanique
statut: en cours
---

# Journal de bord — 23 octobre 2026

## 👥 Intervenants
* **matazzo** (Maé Tazzioli)

---

## 1. Travaux Réalisés

### Pôle Électronique — Comparateur du capteur H21A1 (AOP)
* **Objectif :** obtenir un signal logique propre (0 V / 5 V) à partir de la sortie analogique `A` de la fourche H21A1 : sortie à 5 V si `A` > 2,5 V, à 0 V sinon. Seul le +5 V de la carte est disponible, pas de tension négative.
* **Composants testés :** TL081CN, puis LM318N. Montage avec référence 2,5 V (pont diviseur).
* **Constat :** ni le TL081CN ni le LM318N ne sont *rail-to-rail*. Leur sortie perd environ 1 à 2 V par rapport à chaque alimentation et leurs entrées doivent rester à quelques volts des rails. Alimentés en 5 V simple, ils ne peuvent pas sortir 0 V / 5 V ni lire correctement une entrée à 2,5 V. Le LM318N demande au minimum ±5 V.
* **Solutions retenues pour la suite :**
  * **LM393** (vrai comparateur, 5 V simple, résistance de rappel de 10 kΩ entre sortie et +5 V) : solution la plus adaptée.
  * **MCP6002** (DIP-8) ou **LMV321** (rail-to-rail, boîtier CMS uniquement) : alternatives, câblage sans diodes de protection.
* **Documentation :** la note complète est dans [[comparateur-aop-choix]] (`reports/comparateur-aop-choix.md`).

### Pôle Mécanique / Capteurs — Encodeur sur la courroie de la machine
* **Contexte :** la machine à coudre Facility 21 est entraînée par un moteur via une courroie. On veut ajouter un encodeur rotatif pour mesurer le mouvement.
* **Choix de l'encodeur : SEN0230 (Go Tronic), 6 mm, 400 impulsions/tour, 5000 tr/min max.** Raisons du choix :
  * supporte de hautes fréquences (vitesse de rotation élevée possible) ;
  * nombre d'impulsions élevé, donc bonne précision ;
  * vendu avec un support de fixation ;
  * les autres modèles envisagés étaient des encodeurs à souder, moins pratiques.
  * Fiche technique : `docs/03_Capteurs_et_Synchronisation/fiche_technique_encodeur_sen0230.pdf`.
* **Principe de liaison :** un engrenage ne peut pas s'engrener sur une courroie. Il faut une **poulie de même profil et de même pas que la courroie**, alésage 6 mm, montée sur l'arbre de l'encodeur et en prise sur la courroie.
* **Données de la transmission :**
  * poulie moteur : 9 dents ;
  * grosse poulie : 83 dents (rapport 83/9 ≈ 9,2) ;
  * vitesse maximale de la machine : 860 tr/min, prise ici comme vitesse de la grosse poulie (à confirmer).
* **Dimensionnement de la poulie de l'encodeur (n dents) :**
  * dents défilant par minute : 860 × 83 = 71 380 ;
  * vitesse de l'encodeur : N = 71 380 / n ;
  * condition N ≤ 5000 tr/min, donc **n ≥ 15 dents** (c'est un minimum, pas un maximum : moins de dents, c'est plus de vitesse).

| Dents | Tr/min encodeur à 860 | Impulsions/dent | Impulsions par tour de grosse poulie | Avec ×4 (quadrature) |
|---|---|---|---|---|
| 16 | ≈ 4460 | 25 | 2075 | 8300 |
| 18 | ≈ 3970 | 22,2 | 1844 | 7378 |
| 20 | ≈ 3570 | 20 | 1660 | 6640 |

  * Impulsions par tour de grosse poulie = 400 × 83 / n.
* **Décision :** le choix est entre **16 et 18 dents**. La poulie sera **imprimée en 3D**. Le pas et la largeur de la courroie ne sont pas encore connus ; le nombre de dents définitif sera décidé plus tard.
* **Conseils pour l'impression 3D :**
  * imprimer l'axe à la verticale pour des dents bien formées ;
  * percer l'alésage à environ 6,1–6,2 mm (retrait à l'impression), reprendre à 6 mm si besoin ;
  * prévoir une vis pointeau avec écrou emprisonné dans le moyeu, et un méplat sur l'arbre ;
  * ajouter un petit rebord de chaque côté pour guider la courroie ;
  * matériau PETG ou nylon plutôt que PLA (usure) ;
  * les petits pas (MXL, T2.5) sont difficiles à imprimer en FDM avec une buse de 0,4 mm.

---

## 2. Difficultés Rencontrées & Solutions
* **Tension du capteur qui chute à 2,6 V** quand on le relie à l'entrée de l'AOP, alors qu'elle vaut 5 V à vide. Cause non confirmée. Pistes : alimentation de l'AOP hors spécification (5 V simple), masses non communes, entrées reliées par erreur sur la breadboard.
* **1,6 V mesurés sur une entrée laissée en l'air :** normal, une broche flottante n'est pas à 0 V.
* **Position de l'aiguille vs courroie :** un encodeur sur la courroie mesure le mouvement de la courroie, pas forcément la position de l'aiguille (glissement, rapport de transmission). Si la position de l'aiguille est le but, un montage sur l'arbre principal en 1:1 serait plus fiable.

---

## 3. Prochaines Étapes
- [ ] Commander le LM393 (ou le MCP6002 en DIP-8 ou LMV321) et refaire le montage en 5 V simple
- [ ] Relever le pas et la largeur de la courroie
- [ ] Confirmer vitesse max
- [ ] Vérifier sur la fiche du SEN0230 si les 400 impulsions/tour sont comptées par front ou en quadrature
- [ ] Choisir 16 ou 18 dents, puis modéliser et imprimer la poulie de l'encodeur
- [ ] Concevoir le support de l'encodeur (place disponible autour de la courroie)

---

## ⏱ Historique des commits
* Journal du 23 octobre 2026 : AOP (comparateur H21A1) et choix de l'encodeur SEN0230 avec dimensionnement de la poulie.
