RhomDev/projet_synth-se_broderie/reports/journal/2026-09-29.md

---
titre: Journal de bord - 29 septembre 2026
date: 2026-09-29
tags:
  - journal
  - projet_broderie
  - capteur
  - mks_base
  - electronique
  - management
statut: termine
---

# Journal de bord — 29 septembre 2026

## 👥 Intervenants
* **RhomDev** (Romaric Pradeau)
* **matazzo** (Maé Tazzioli)

---

## 1. Étude et intégration du capteur de position aiguille (H21A1)
* **Documentation :** Ajout de la documentation technique de la fourche optique ([[capteur_position_H21A1.pdf]]).
* **Rapport technique ([[rapport_capteur_h21a1|rapport_capteur_h21a1.md]]) :**
  * **Rôle critique :** Détection de la position haute de l'arbre principal afin de synchroniser les déplacements du cadre $X/Y$ et d'empêcher tout déplacement pendant la pénétration du tissu par l'aiguille.
  * **Vitesse de commutation :** Analyse de la courbe de commutation issue de la datasheet (![[Screenshot From 2026-09-29 14-12-44.png]]). Avec une vitesse de rotation de l'arbre pouvant atteindre ~1000 tr/min, les temps de réponse ($t_{\text{on}}$ et $t_{\text{off}}$) doivent être réduits au maximum. Choix d'une résistance de charge $R_L$ faible (entre $1\text{ k}\Omega$ et $2{,}5\text{ k}\Omega$).
  * **Intégration MKS Base :** Alimentation sous $5\text{ V}$, raccordement sur une entrée *Endstop*, et lecture gérée par interruptions matérielles (*Hardware Interrupts*) sur microcontrôleur ATmega afin de ne manquer aucun front à haute vitesse.

---

## 2. Architecture matérielle & carte de commande MKS Base V1.4
* Rédaction de la note d'architecture ([[carte_de_commande_mks_base_v1_4|carte_de_commande_mks_base_v1_4.md]]) :
  * Définition de la carte MKS Base V1.4 comme cerveau du système (contrôleurs de puissance intégrés pour moteurs pas-à-pas $X/Y$, acquisition capteurs, boucle de synchronisation).
  * Ajout de la datasheet du microcontrôleur ([[ATMEGA640.PDF]]).

---

## 3. Gestion de projet & planification
* **Feuille de route machine ([[Tache sur machine|Tache sur machine.md]]) :**
  * *Tâches immédiates :* Câblage des moteurs pas-à-pas $X$ et $Y$, câblage de la fourche optique H21A1, raccordement d'un relais pour la commande moteur, montage d'un encodeur sur la roue de travail.
  * *Tâches futures :* Conception d'un hacheur pour la régulation de vitesse, butées de fin de course $X/Y$, écran LCD, laser de distance pour *homing*.
* **Diagramme de Gantt (`Projet sans titre 1.gan`) :**
  * Planification des lots : Découverte plateforme, Développement logiciel (compilation G-code et vectorisation en Python), Conception module (détection aiguille), Développement CN Arduino (lecture G-code, déploiement et tests de tracés).

---

## 4. Configuration d'Obsidian & Collaboration
* Initialisation et configuration du coffre Obsidian (plugins de base, affichage graphe, modèles).
* Synchronisation et fusion des dépôts distants entre collaborateurs (commit de merge `7eaccfd`).

---

# 5. Éducation sur l'exploitation d'un signal PWM (Analyse d'une fausse piste)

## 5.1. L'origine de la confusion : La datasheet du capteur H21A1
Lors de l'étude du capteur optique à fente H21A1 pour détecter la position de l'aiguille, l'analyse de sa datasheet a mené à une erreur d'interprétation[cite: 5]. Les graphiques du constructeur indiquaient des paramètres de test spécifiques :
* **PW (Pulse Width)** : Largeur d'impulsion fixée à 300 µs[cite: 5].
* **PRR (Pulse Repetition Rate)** : Taux de répétition des impulsions à 100 pps (100 Hz)[cite: 5].

En pensant qu'il s'agissait des paramètres électriques nécessaires pour alimenter et lire le capteur, des recherches ont été menées (`Configuration_PWM_Arduino`) pour modifier les registres du microcontrôleur[cite: 5]. Le but de cette fausse piste était de générer un signal PWM (Modulation par Largeur d'Impulsion) capable de recréer ces impulsions spécifiques pour l'acquisition des données[cite: 5].

## 5.2. Pourquoi le PWM était une fausse piste pour l'acquisition
Cette approche logicielle s'est révélée inadaptée pour le système de broderie pour plusieurs raisons :
* **Interprétation de la datasheet :** Les valeurs PW et PRR mentionnées ne sont pas des exigences de fonctionnement, mais uniquement des conditions de test standardisées en laboratoire par le fabricant pour mesurer les temps de réaction du phototransistor[cite: 5].
* **Besoin d'une alimentation continue :** La diode infrarouge émettrice du capteur H21A1 n'a pas besoin de signal PWM. Elle doit être alimentée par une tension continue et constante de 5V pour émettre un faisceau lumineux ininterrompu[cite: 5].
* **Le danger de l'échantillonnage PWM :** Alimenter ou lire le capteur au rythme d'un signal PWM (même rapide) signifie que le capteur est "aveugle" pendant les phases basses du signal. À une vitesse de 1000 tr/min, le drapeau mécanique passe très rapidement dans la fente[cite: 5]. Si ce passage s'effectue pendant une fraction de milliseconde où le PWM est à l'état bas, le microcontrôleur ratera l'information, entraînant une désynchronisation de la machine[cite: 5].

## 5.3. La véritable méthode d'acquisition (Interruptions matérielles)
Pour lire les données du H21A1 de manière fiable, la logique du PWM a été abandonnée au profit d'une lecture asynchrone continue :
* La fréquence d'acquisition n'est plus fixée par un réglage PWM de la carte, mais correspond naturellement à la vitesse mécanique de l'arbre de la machine (soit environ 16,6 Hz à vitesse maximale)[cite: 5].
* Le signal du capteur est lu via les **interruptions matérielles** de l'ATmega2560 (par exemple sur la broche 19 / INT2)[cite: 7, 9]. 
* L'acquisition est configurée pour détecter un front descendant (`FALLING`)[cite: 6, 7]. Ainsi, c'est le capteur lui-même qui "réveille" le processeur à l'instant exact du changement d'état, garantissant une détection absolue sans bloquer les calculs de déplacement des moteurs[cite: 6, 7].

---

## ⏱ Historique des commits de la journée
* **13:43:41** (`268ca1d` - *matazzo*) : `publish doc capteur position`
* **13:51:31** (`929e14b` - *RhomDev*) : `ajouter des tache machine`
* **14:14:04** (`aa1e685` - *RhomDev*) : `rapport capteur`
* **14:19:59** (`7db364f` - *matazzo*) : `datasheet microcontroleur`
* **14:20:23** (`7eaccfd` - *matazzo*) : `Merge branch 'main' of https://github.com/RhomDev/projet_synth-se_broderie`
