RhomDev/projet_synth-se_broderie/reports/journal/2026-09-30.md

---
titre: Journal de bord - 30 septembre 2026
date: 2026-09-30
tags:
  - journal
  - projet_broderie
  - capteur
  - mks_base
  - electronique
  - variateur_ac
  - kicad
  - management
statut: termine
---

# Journal de bord — 30 septembre 2026

## 👥 Intervenants
* **RhomDev** (Romaric Pradeau)
* **matazzo** (Maé Tazzioli)

---

## 1. Conditionnement du capteur de position aiguille (H21A1) & Conception PCB sous KiCad
* **Diagnostic électrique ([[mise_en_service_capteur_h21a1|mise_en_service_capteur_h21a1.md]]) :**
  * Lors des tests d'intégration du capteur optique à fente H21A1 sur la carte MKS Base V1.4, une anomalie de niveau logique a été identifiée.
  * À vide, le capteur commute proprement entre $5\text{ V}$ et environ $0{,}8\text{ V}$.
  * En revanche, une fois raccordé à l'entrée numérique du microcontrôleur ATmega2560, la tension basse remonte à $2{,}0\text{ V} - 2{,}5\text{ V}$ en raison des résistances internes de tirage (*pull-up*) de la carte hôte. Cette tension se situe en pleine zone d'indécision logique TTL/CMOS, empêchant tout déclenchement fiable d'interruption matérielle.
* **Développement de la carte d'adaptation (AOP en comparateur) :**
  * Conception d'un étage intermédiaire de mise en forme du signal basé sur un amplificateur opérationnel (AOP type LM741) monté en comparateur de tension avec seuil réglable par potentiomètre.
  * L'AOP compare la tension issue du phototransistor avec la référence ajustable : la sortie bascule de façon nette et franche à $0\text{ V}$ ou $5\text{ V}$ purs, sans zone d'incertitude (![[montage_correction.png]]).
* **Routage et CAO sous KiCad (`hardware/elect/carte_acquisition_capteur/`) :**
  * Saisie du schéma électronique (`carte_acquisition_capteur.kicad_sch`).
  * Routage du circuit imprimé (`carte_acquisition_capteur.kicad_pcb`).
  * Définition des empreintes mécaniques de perçage et de fixation (`MountingHole_1.2mm`, `MountingHole_3.2mm`, `MountingHole_65mil`).
* **Validation logicielle par interruption matérielle (`src/arduino/test_H21A1/test_H21A1.ino`) :**
  * Développement d'un code de test sur microcontrôleur configurant l'interruption externe `INT2` sur la broche `PD2` (Pin 19) sur front descendant (`FALLING` : `ISC21 = 1`, `ISC20 = 0` dans le registre `EICRA`).
  * La routine d'interruption `ISR(INT2_vect)` arme un drapeau volatile qui déclenche l'allumage de la broche `PB7` (Pin 13) pour vérifier la réactivité instantanée de la détection.

---

## 2. Étude de la variation de vitesse du moteur AC (Module RobotDyn)
* **Évolution de la commande moteur :**
  * Abandon de la commande binaire par simple relais électromécanique, jugée inadaptée en raison des à-coups mécaniques et de l'incapacité d'ajuster la vitesse de couture.
  * Sélection du **Module Variateur AC RobotDyn 1 Canal** ($3{,}3\text{ V}/5\text{ V}$, $110\text{ V}/230\text{ V AC}$, $50/60\text{ Hz}$).
* **Analyse comparative Fast PWM vs Découpe de Phase :**
  * Analyse de la génération PWM haute fréquence sur Arduino (`[[Configuration_PWM_Arduino|Configuration du PWM sur Arduino]]`) : calcul du registre `ICR1` du Timer 1 ($TOP = 639$ avec $f_{CPU} = 16\text{ MHz}$ et prédiviseur $N=1$) pour atteindre une fréquence cible de $25\text{ kHz}$.
  * Démonstration théorique de l'inapplicabilité d'un PWM continu standard sur un TRIAC, ce dernier restant conducteur jusqu'à l'annulation naturelle du courant alternatif.
* **Rédaction du dossier technique complet (`[[Module variateur AC]]`) :**
  * Analyse physique du fonctionnement par découpe de phase synchronisée sur la détection de passage par zéro (`ZC` - *Zero-Crossing*).
  * Explication de la chaîne d'isolation galvanique assurée par les optocoupleurs (optocoupleur ZC et opto-TRIAC à amorçage instantané MOC3021 pour la gâchette `PSM`).
  * Prise en compte des contraintes inductives du moteur de machine à coudre : protection par circuit *snubber* RC (résistance + condensateur X2) et varistance (MOV) contre les fortes surtensions $e = -L \frac{di}{dt}$ et les déclenchements parasites par $\frac{dv}{dt}$.
  * Définition du schéma de raccordement sur la carte MKS Base V1.4 et élaboration d'exemples de code Arduino (via la bibliothèque `RBDdimmer` ou par timer interne).

---

## 3. Structuration et Gabarits Obsidian
* **Standardisation des notes :**
  * Création du fichier modèle `Tempelate.md` intégrant le schéma de métadonnées YAML (*frontmatter* : titre, date, tags, statut) afin d'unifier la base de connaissances du projet.
  * Organisation et classement des fiches techniques relatives aux capteurs de fin de course / synchronisation et aux modules de puissance.

---

## ⏱ Historique des commits de la journée
* **16:19:00** (`9c4b3a8d` - *RhomDev*) : `montage élect proposé`
