RhomDev/projet_synth-se_broderie/docs/templates/Template_Journal.md

---
titre: Journal de bord - {{date}}
date: {{date}}
tags:
  - journal
  - projet_broderie
statut: en cours
---

# Journal de bord — {{date}}

## 👥 Intervenants
* **RhomDev** (Romaric Pradeau)S
* **matazzo** (Maé Tazzioli)

---

## 1. Travaux Réalisés
<!-- Résumer les réalisations du jour (mécanique, électronique, logiciel, tests) -->
* **Pôle Matériel :** 
* **Pôle Logiciel :** 

---

## 2. Difficultés Rencontrées & Solutions
<!-- Décrire les bugs, anomalies de mesure ou blocages, et les solutions apportées -->

---

## 3. Prochaines Étapes
<!-- Liste des priorités pour la prochaine séance -->
- [ ] 
- [ ] 

---

## ⏱ Historique des commits
* **HH:MM:SS** (`commit_id` - *Auteur*) : `Message de commit`
