RhomDev/projet_synth-se_broderie/reports/journal/2026-10-01.md

---
titre: Journal de bord - 01 octobre 2026
date: 2026-10-01
tags:
  - journal
  - projet_broderie
  - architecture
  - obsidian
  - management
statut: journal
---

# Journal de bord — 01 octobre 2026

## 👥 Intervenants
* **RhomDev** (Romaric Pradeau)
* **matazzo** (Maé Tazzioli)

---

## 1. Restructuration Globale du Projet & Knowledge Management
* **Constat initial :** Dispersion des notes techniques et des fichiers entre `data/`, `docs/`, `reports/`, ainsi qu'une pollution par des archives web brutes dans les dossiers de travail. Manque de lisibilité et absence de point d'entrée centralisé dans Obsidian.
* **Refonte de l'arborescence documentaire :**
  * Regroupement de l'ensemble de la base de connaissances dans un dossier [`docs/`](file:///home/rhomdev/Documents/Ecole/projet_synth-se_broderie/docs/) hiérarchisé par spécialités :
    * `01_Gestion_Projet/` (Cahier des charges, suivi de tâches, diagramme Gantt).
    * `02_Electronique_et_Puissance/` (Carte MKS Base V1.4, Variateur AC RobotDyn, Fast PWM 25 kHz).
    * `03_Capteurs_et_Synchronisation/` (Fourche optique H21A1, carte de conditionnement comparateur AOP).
    * `04_Mecanique_et_Cinematique/` (Plateau XY, calculs de résolution et synchronisation de déplacement).
    * `05_Logiciel_et_Firmware/` (Architecture pipeline Python/G-code et microcontrôleur Arduino).
  * Centralisation des schémas et images dans `docs/assets/` et des documentations constructeurs dans `docs/datasheets/`.
  * Redéfinition du rôle du dossier [`data/`](file:///home/rhomdev/Documents/Ecole/projet_synth-se_broderie/data/) exclusivement pour les fichiers de données d'exécution (`data/gcode/` et `data/mesures/`).

---

## 2. Déploiement du Tableau de Bord & Canvas Interactif sous Obsidian
* **Création du Tableau de Bord central ([[00_Tableau_de_Bord]]) :**
  * Mise en place d'un hub interactif avec Map of Content (MOC), schéma architectural Mermaid complet, accès instantané aux fiches techniques, journaux de bord et datasheets.
* **Conception du Canvas système ([[Projet_Broderie.canvas]]) :**
  * Modélisation graphique des interconnexions physiques et logiques reliant l'ordinateur hôte (Python), la carte MKS Base, les capteurs (H21A1 + AOP) et les actionneurs (moteurs pas-à-pas XY et variateur AC).
* **Création des modèles de notes (`docs/templates/`) :**
  * [[Template_Fiche_Technique.md]]
  * [[Template_Journal.md]]
  * [[ Template_Tache.md]]
  * Configuration de l'environnement Obsidian (`.obsidian/templates.json` et `.obsidian/app.json`) pour pointer vers les templates et le répertoire d'assets.

---

## 3. Consolidation Technique & Résolution des Liens
* **Spécifications :** Rédaction formelle du cahier des charges ([[Cahier_des_Charges]]) synthétisant les objectifs du module broderie.
* **Mécanique :** Formalisation de la note cinématique du plateau XY ([[Plateau_XY_et_Mecanique]]) détaillant la contrainte d'immobilité du tissu pendant la pénétration de l'aiguille.
* **Électronique & Capteurs :** Harmonisation de toutes les notes matérielles avec un système d'alias étendu pour garantir une rétrocompatibilité parfaite de tous les liens internes Obsidian existants.
* **Firmware :** Documentation du pipeline de communication et d'ordonnancement temps réel ([[Architecture_Logicielle]]).

---

## ⏱ Historique des commits de la journée
* **11:19:27** (`1fb56aa` - *RhomDev*) : `module de variation AC`
* **Session après-midi** : Restructuration complète de l'architecture du projet et déploiement du système de gestion des connaissances Obsidian.
- 20:17:57 (15193dd - RhomDev) : correction de texte
- 17:27:36 (066b93d - RhomDev) : mise a jour de l'organisation des dossier
- 11:19:27 (1fb56aa - RhomDev) : module de variation AC
