RhomDev/projet_synth-se_broderie/(commit log)

2026-09-29 ajouter des tache machine
2026-09-30 montage élect proposé
    [carte_acquisition_capteur.kicad_pcb, carte_acquisition_capteur.kicad_sch]
2026-10-01 module de variation AC
2026-10-01 mise a jour de l'organisation des dossier
2026-10-01 correction de texte
2026-10-09 ajout du circuit de variation AC
2026-10-23 Add files via upload
    Ajout fiche technique de la machine à coudre
2026-10-23 Add files via upload
    Document permettant qui décrit ce qui n'allait pas avec nos aop, et que choisir pour que ça marche
2026-10-23 Add files via upload
    Fiche technique de l'encodeur qui je penses est le meilleur.
2026-11-03 mj du projet grant, plus redesign de l'arborécence
2026-11-03 mj suivi de projet
2026-11-05 program arduino mj
2026-11-09 mj code_carte arduino
2026-11-09 mj code arduino
